NeuralSyntaxLab/Bird-Scale-Methods-Article/article/Figures/Figure_2_Average_Weight_per_day.png

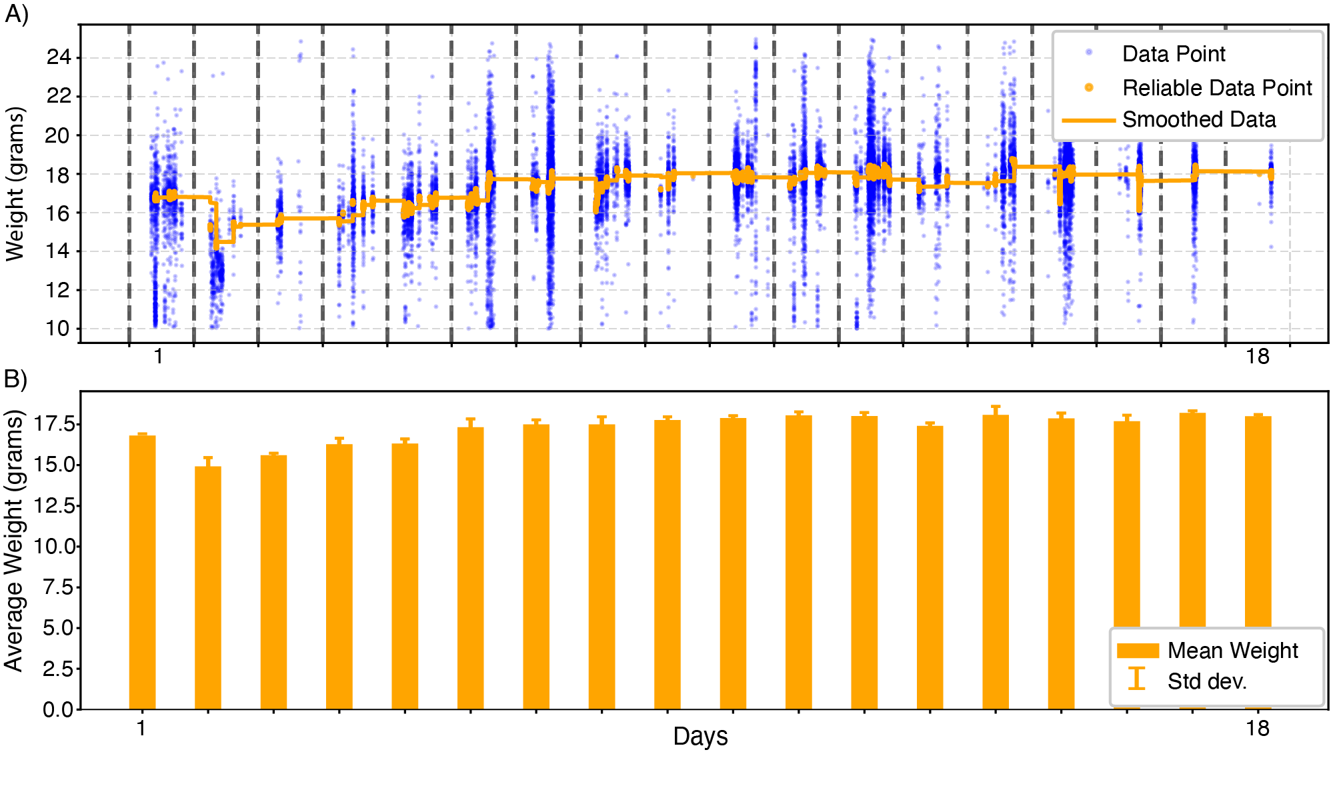
article/Figures/Figure_2_Average_Weight_per_day.png
