NeuralSyntaxLab/Bird-Scale-Methods-Article/article/Figures/Figure_3_Histogram.png

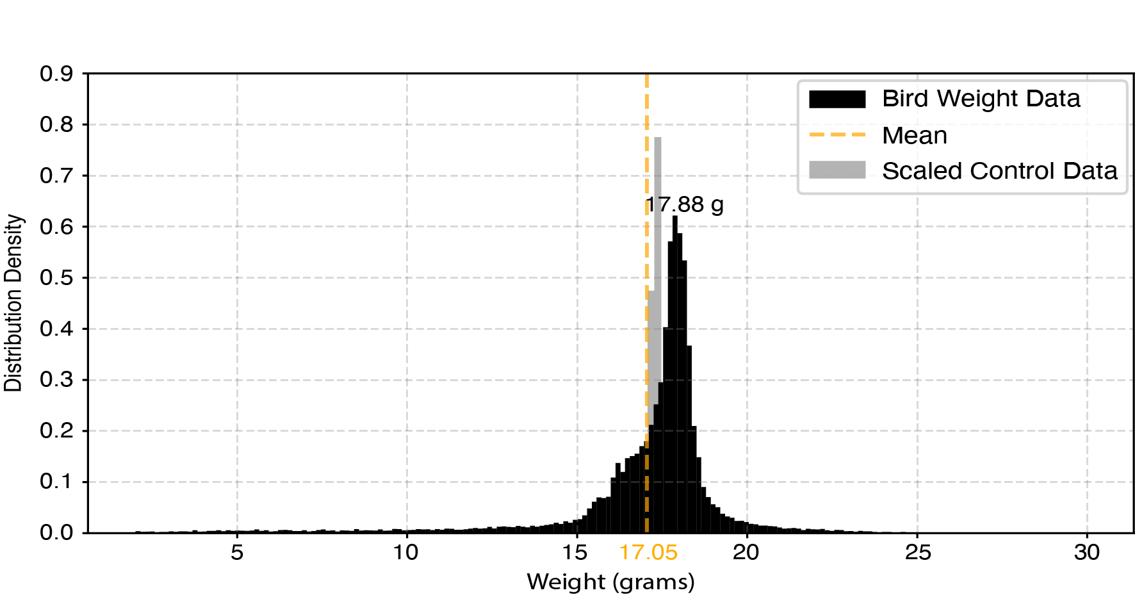
article/Figures/Figure_3_Histogram.png
