NeuralSyntaxLab/Bird-Scale-Methods-Article/article/Figures/Figure_4_Regression.png

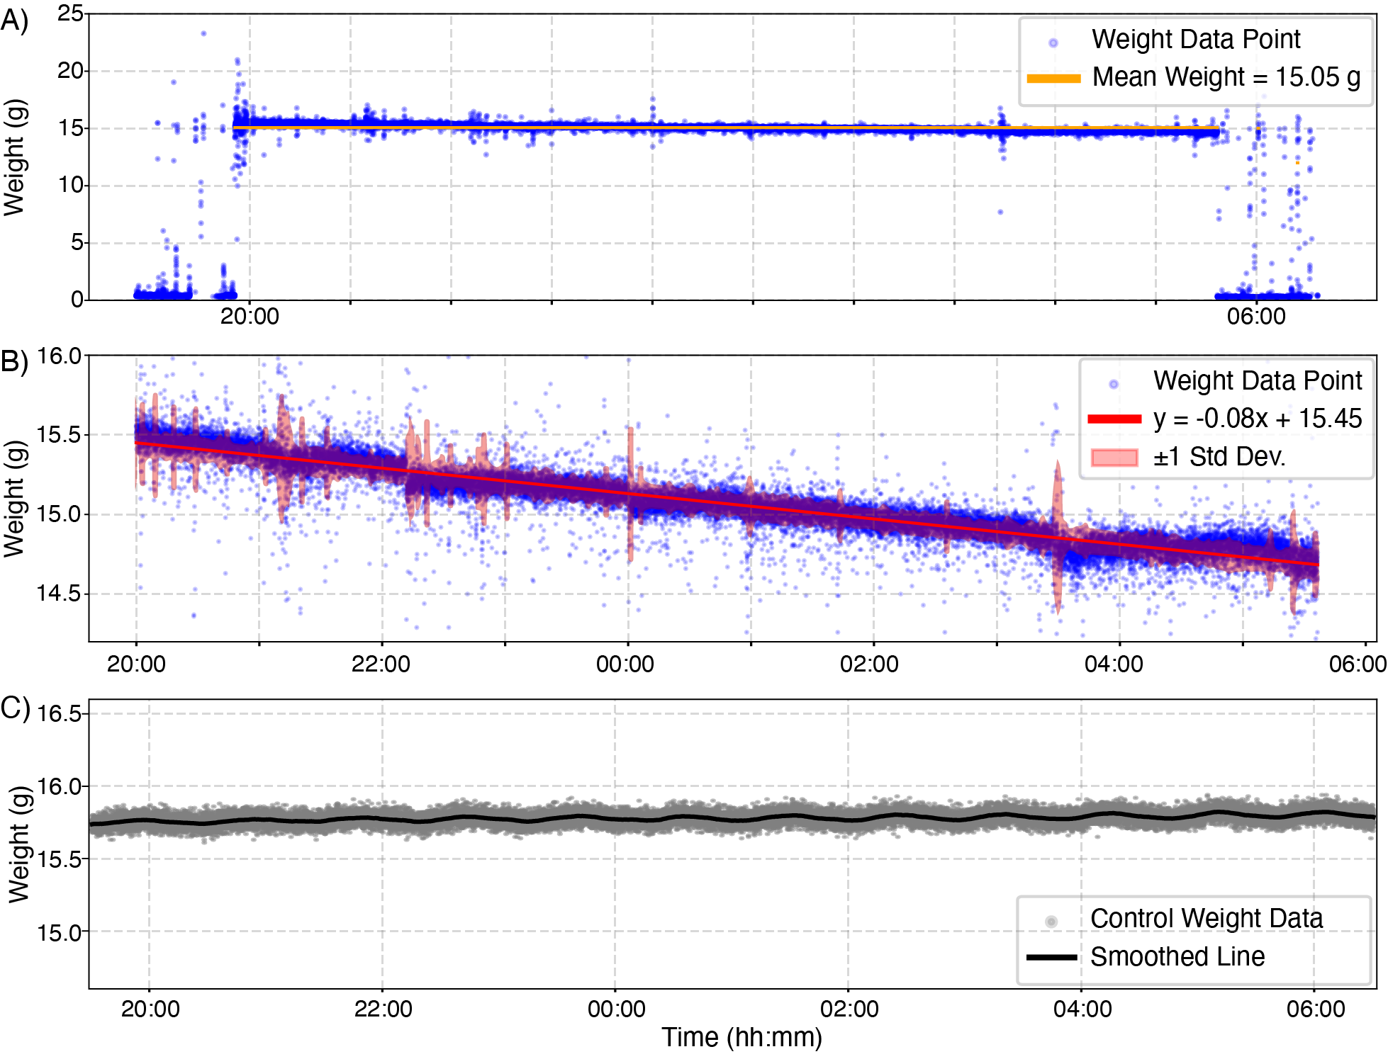
article/Figures/Figure_4_Regression.png
