NeuralSyntaxLab/Bird-Scale-Methods-Article/Mechanical design/Assembly1.stp

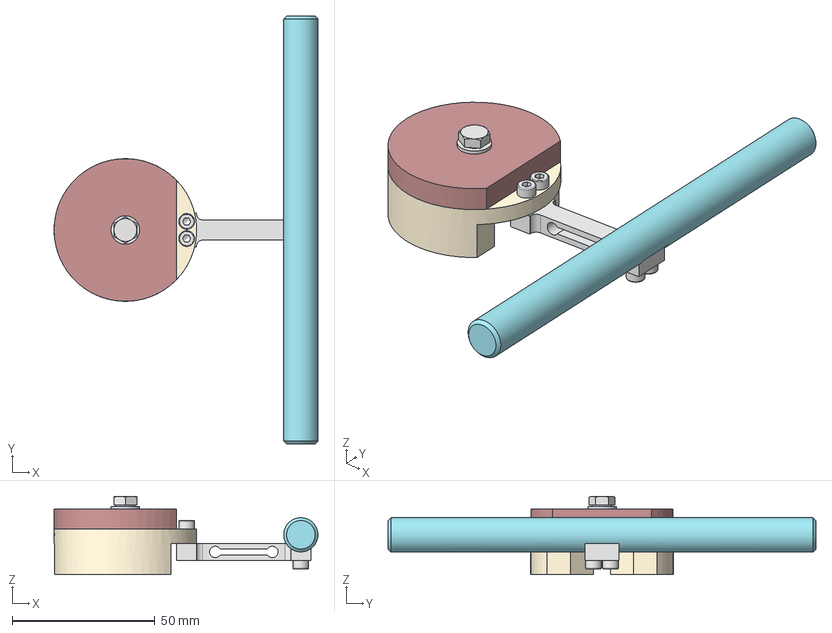
[picture p4: CAD file, 2024-09-30]
Mechanical design/Assembly1.stp
92.5 x 150.0 x 27.5 mm
Sensor
Base
Pin
ISO 4762 - M3 x 10 x 4
Weight
ISO 7089 - 5
ISO 4017 - M5 x 12
