NeuralSyntaxLab/Bird-Scale-Methods-Article/(commit log)

2024-09-30 Update #2
    addition of all current items:
    1. parts list
    2. scale design
    3. arduino code
    [Assembly1.stp, Scale_system_parts_list.xlsx]
2024-09-30 Addition of Scale System user guides
    1. Setup and operation guide
    2. assembly guide
2024-09-30 addition of arduino calibration code
2024-10-20 Update repository structure
    [Assembly1.stp]
